ThiwankaReiss/Steering_mini_car_falcone/ADS DV.docx

Automated Driving

System (ADS)

By Thiwanka Reiss

## Summary

(100-200 words)

## Table of Contents

# 1 CAN Bus implementation (Controller Area network)

FS-AI_API (https://github.com/FS-AI/FS-AI_API) has been, as a reference for teams to start implementing their vehicle interface code.

After inspection of the API we were able to identify that this code was written on a Linux based system and socket can have been used, but we are planning to use a NUCLEO L037RZ (STM32) as the low-level micro controller which do not support Linux, it supports bare-metal C/C++.

Data frames and program structure in the code was identified and changed to work for our use case in the NUCLEO L037.

Here our focus is sending data to the VCU from API and receiving data from VCU to the API.

Some the Data frames that were identified and added to Readme file of our repository is shown below. (Note that code is fully implemented, some data frames is yet to be added to the ReadMe file)

Repository: - https://github.com/FalconE-Racing/DV_Real.git

Data frames Used to Communicate from the Api to VCU (User side - Set Method)

Frame Id | Frame Use
0x510 | VCU status
0x511 | Drive Forward
0x512 | Drive Rear
0x513 | Steering
0x514 | Brake

Note that the bits in a byte are numbered from zero to seven

VCU Status
Frame Id:- 0x510
DLC :- 8

Byte | Signal | Description
data0 | Hand shake bit | Only the 0th bit is used where, 1 = bit recived , 0 = bit not received
data1 | Dirrection , mission and stop request | 6 th bit , 1 = Forward , 0 = Neutral
| | 5th, 4th bit , 0 = Mission not selected, 1 = Mission selected, 2 = Mission Running, 3 = Mission Finished
| | 0th bit , 0 = Emenrgency Stop No , 1 = Emergency Stop Yes
data2 | Lap Counter | 0th to 3rd bit , maximum of 15 laps is expected
data3 | Cone Count | Expecting value from 0 - 255
data4 | Total Cone Count | 0th to 7th bits of Total cone count
data5 | TOtal Cone Count | 8th to 17th bit of Total cone count

Drive Forward
Frame Id:- 0x511
DLC :- 4

Byte | Signal | Description
data0 | Front Axel Torque Request | 0th to 7th bits of Torque Request
data1 | Front Axel Torque Request | 8th to 15th bits of Torque Request
data2 | Front Axel Motor Speed Request | 0th to 7th bits of Motor Speed Request
data3 | Front Axel Motor Speed Request | 8th to 15th bits of Motor Speed Request

Drive Rear
Frame Id:- 0x512
DLC :- 4

Byte | Signal | Description
data0 | Rear Axel Torque Request | 0th to 7th bits of Torque Request
data1 | Rear Axel Torque Request | 8th to 15th bits of Torque Request
data2 | Rear Axel Motor Speed Request | 0th to 7th bits of Motor Speed Request
data3 | Rear Axel Motor Speed Request | 8th to 15th bits of Motor Speed Request

Steering
Frame Id:- 0x513
DLC :- 2

Byte | Signal | Description
data0 | Steer Angle Request | 0th to 7th bits of Steer Angle Request
data1 | Steer Angle Request | 8th to 15th bits of Steer Angle Request

Brake
Frame Id:- 0x514
DLC :- 2

Byte | Signal | Description
data0 | Forward Pressure Required | Expecting value from 0 - 255
data1 | Rear Pressure Required | Expecting value from 0 - 255

Data frames Used to Communicate from the VCU to Api (User side - Get Method)

Frame Id | Frame Use
0x520 | VCU status
0x521 | Drive Forward
0x522 | Drive Rear
0x523 | Steering
0x524 | Brake
0x525 | Wheel Speed
0x526 | Wheel Count

VCU Status
Frame Id:- 0x520
DLC :- 3

Byte | Signal | Description
data0 | Hand shake bit | Only the 0th bit is used where, 1 = bit recived , 0 = bit not received
data1 | Ready to GO Signal | 3rd bit, 1 = Ready to Go, 0 = Not Ready to Go
data2 | Autonomous State (AS) | 0th to 3rd bit is used , five states are present
| | 1 - Off/ Manual
| | 2 - Ready
| | 3 - Driving
| | 4 - Emergency Brake
| | 5 - Finished
| Autonomous Mission Indicator (AMI) | 4th to 7th bit , seven states are present
| | 0 - AMI Not Selected
| | 1 - AMI Accelleration
| | 2 - AMI Skidpad
| | 3 - AMI Autocross
| | 4 - AMI Trackdrive
| | 5 - AMI Static Inspection A
| | 6 - AMI Static Inspection B
| | 7 - AMI Autonomous Demo

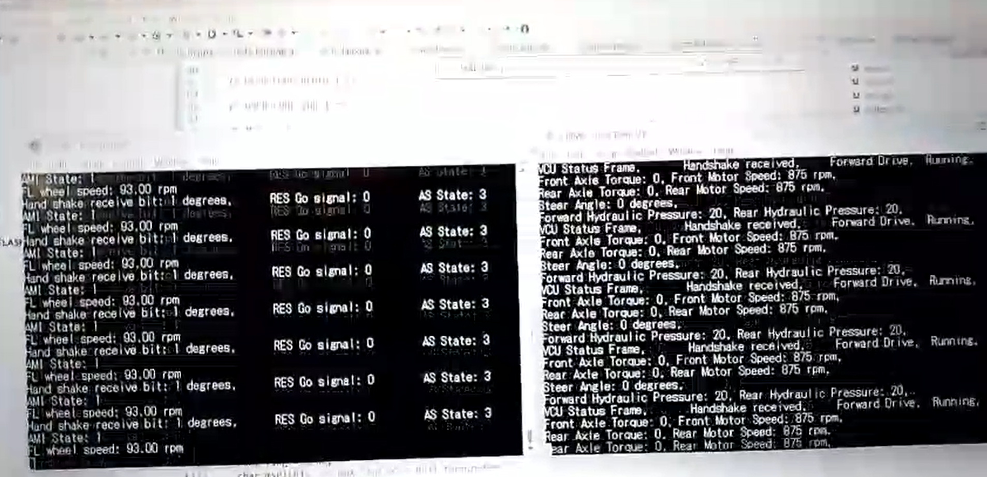
[picture p2: figure]

Designing smaller four-wheel robot for testing out the driverless stack.

To test out our code we are planning to implement a smaller four-wheel robot. A steering system was developed for the robot. Some calculations were done regarding the mechanism using python.

Wheel base = 20cm

Distance between front and rear axel = 22.22cm

Maximum steering angle = 40.1 deg

Distance from mid-point of read axel to mean of canters of rotation =30cm

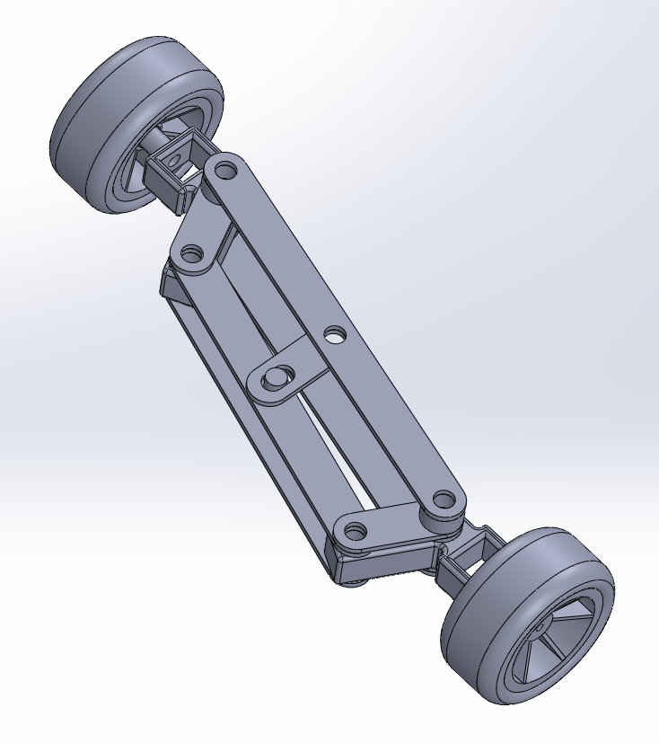
[picture p3: figure]

Calculating maximum steer angle, centre of rotation and other parameters required for the design.

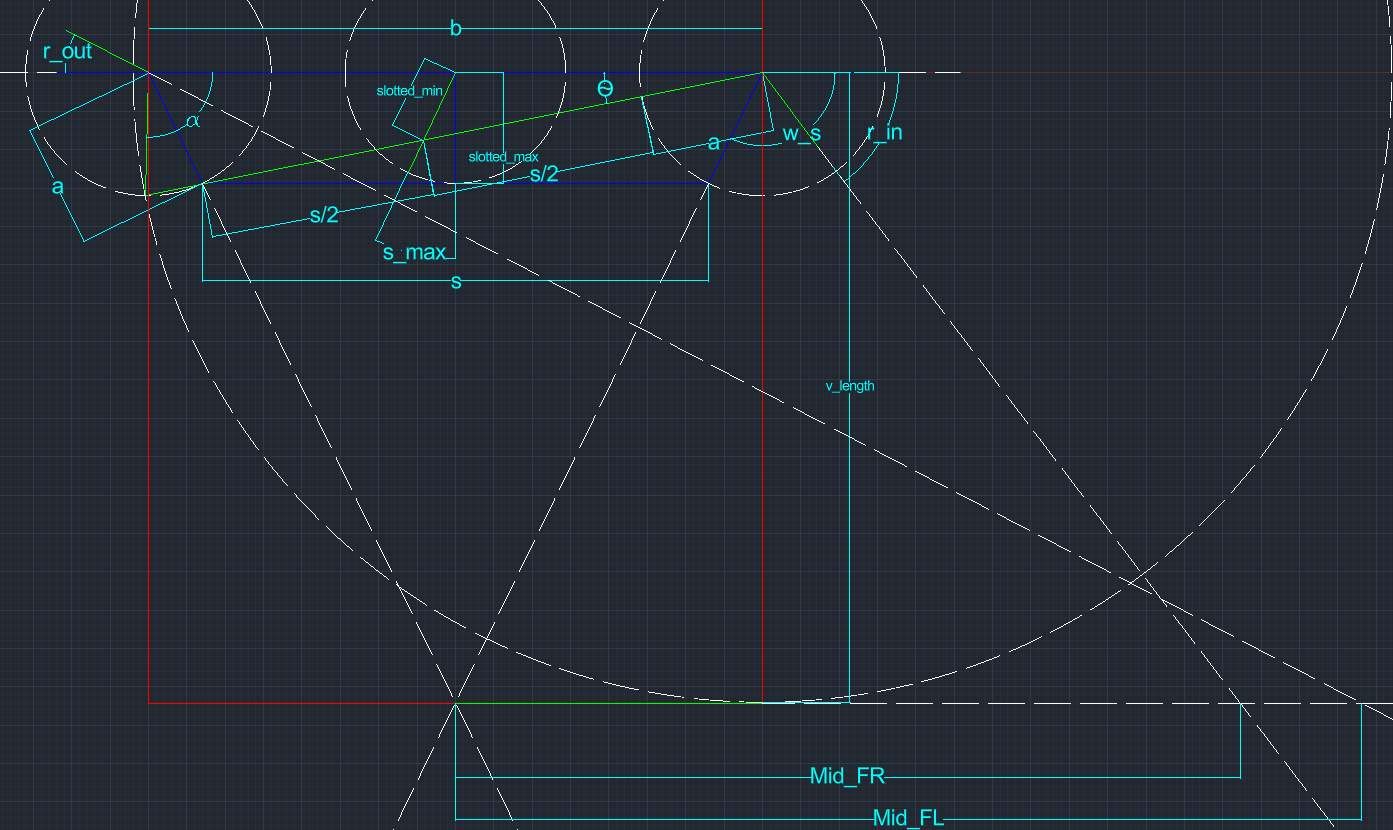
[picture p4: figure]

Slotted Level Max Length=slotted_max=√(a^2 -((b-s)/2)^2)

⁡θ=cos^(-1) (b^2 +(s+a)^2 -a^2)/(2⋅b⋅(s+a))

Slotted Level Min Length = slotted_min=√((b/2)^2 +(s/2, a)^2 -2⋅b/2⋅(s/2, a)⋅cos⁡θ)

Max Steering Angle=cos^(-1) (((b/2)^2 +(slotted_min)^2 -(s/2, a)^2)/(2⋅b/2⋅slotted_min))-90

Vehicle Length=v_length =(a⋅b)/(b-s)

180-w_s=cos^(-1) ((b-s)/(2a))⁡

w_s=180-cos^(-1) ((b-s)/(2a))

r_in=(180-w_s)-θ

α=cos^(-1) ((b^2 -(s+a)^2 +a^2)/(2⋅b⋅a))

r_out=α-(180-w_s)

Mid_FL=((v_length)/(tan(r_(out) )))-b/2

Mid_FR=((v_length)/(tan⁡(r_in)))+b/2

Average= (Mid_FL+ Mid_FR)/2

SolidWorks Simulation

Steering angle vs Iner front wheel.

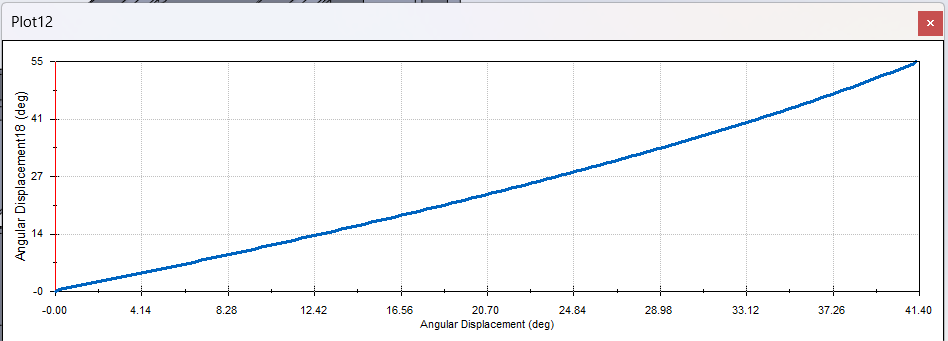
[picture p5: figure]

Steering angle vs Outer front wheel.

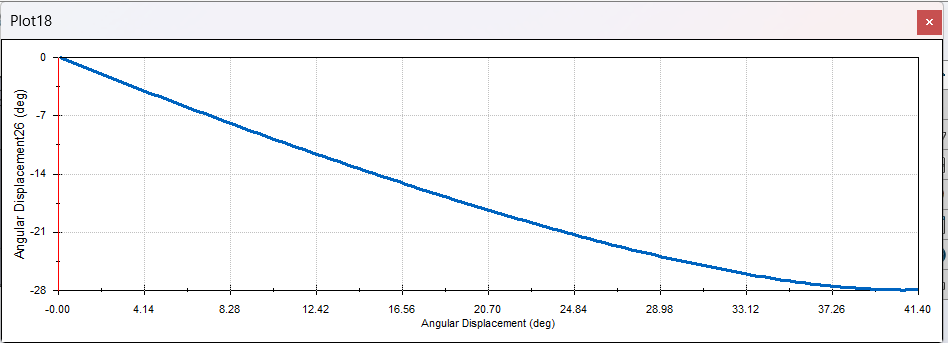
[picture p6: figure]
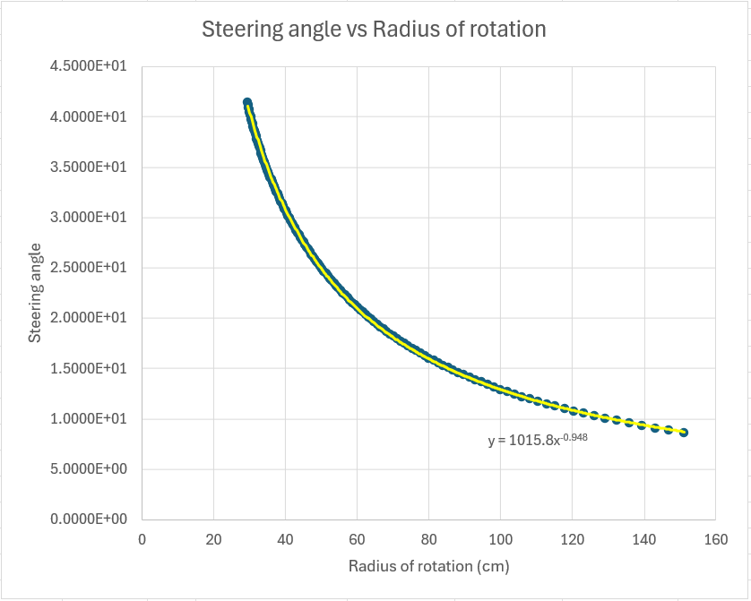
[picture p7: figure]

Solid works data

Steering Angle (deg) | Outer wheel angle (deg) | Inner Wheel Angle (deg)
Ref. Coordinate System: | Ref. Coordinate System: | Ref. Coordinate System:
-1.2762E-14 | 5.1659E-11 | -2.8010E-11
2.3931E-01 | -2.4055E-01 | 2.3806E-01
4.7861E-01 | -4.8051E-01 | 4.7671E-01
7.1792E-01 | -7.1988E-01 | 7.1595E-01
9.5723E-01 | -9.5867E-01 | 9.5578E-01
1.1965E+00 | -1.1969E+00 | 1.1962E+00
1.4358E+00 | -1.4345E+00 | 1.4372E+00
1.6751E+00 | -1.6715E+00 | 1.6788E+00
1.9145E+00 | -1.9079E+00 | 1.9210E+00
2.1538E+00 | -2.1437E+00 | 2.1638E+00
2.3931E+00 | -2.3790E+00 | 2.4072E+00
2.6324E+00 | -2.6136E+00 | 2.6511E+00
2.8717E+00 | -2.8477E+00 | 2.8957E+00
3.1110E+00 | -3.0811E+00 | 3.1408E+00
3.3503E+00 | -3.3140E+00 | 3.3866E+00
3.5896E+00 | -3.5463E+00 | 3.6329E+00
3.8289E+00 | -3.7780E+00 | 3.8798E+00
4.0682E+00 | -4.0091E+00 | 4.1274E+00
4.3075E+00 | -4.2395E+00 | 4.3755E+00
4.5468E+00 | -4.4694E+00 | 4.6242E+00
4.7861E+00 | -4.6987E+00 | 4.8736E+00
5.0254E+00 | -4.9274E+00 | 5.1235E+00
5.2647E+00 | -5.1555E+00 | 5.3740E+00
5.5040E+00 | -5.3829E+00 | 5.6252E+00
5.7434E+00 | -5.6098E+00 | 5.8769E+00
5.9827E+00 | -5.8361E+00 | 6.1293E+00
6.2220E+00 | -6.0617E+00 | 6.3822E+00
6.4613E+00 | -6.2868E+00 | 6.6358E+00
6.7006E+00 | -6.5112E+00 | 6.8900E+00
6.9399E+00 | -6.7350E+00 | 7.1448E+00
7.1792E+00 | -6.9582E+00 | 7.4002E+00
7.4185E+00 | -7.1808E+00 | 7.6563E+00
7.6578E+00 | -7.4027E+00 | 7.9129E+00
7.8971E+00 | -7.6240E+00 | 8.1702E+00
8.1364E+00 | -7.8447E+00 | 8.4282E+00
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
3.4699E+01 | -2.6809E+01 | 4.2591E+01
3.4939E+01 | -2.6898E+01 | 4.2980E+01
3.5178E+01 | -2.6985E+01 | 4.3372E+01
3.5417E+01 | -2.7070E+01 | 4.3766E+01
3.5657E+01 | -2.7151E+01 | 4.4163E+01
3.5896E+01 | -2.7230E+01 | 4.4563E+01
3.6135E+01 | -2.7306E+01 | 4.4965E+01
3.6375E+01 | -2.7379E+01 | 4.5371E+01
3.6614E+01 | -2.7449E+01 | 4.5779E+01
3.6853E+01 | -2.7516E+01 | 4.6191E+01
3.7092E+01 | -2.7580E+01 | 4.6606E+01
3.7332E+01 | -2.7641E+01 | 4.7024E+01
3.7571E+01 | -2.7698E+01 | 4.7445E+01
3.7810E+01 | -2.7752E+01 | 4.7870E+01
3.8050E+01 | -2.7802E+01 | 4.8298E+01
3.8289E+01 | -2.7849E+01 | 4.8730E+01
3.8528E+01 | -2.7892E+01 | 4.9165E+01
3.8768E+01 | -2.7931E+01 | 4.9605E+01
3.9007E+01 | -2.7967E+01 | 5.0048E+01
3.9246E+01 | -2.7998E+01 | 5.0496E+01
3.9486E+01 | -2.8025E+01 | 5.0947E+01
3.9725E+01 | -2.8048E+01 | 5.1403E+01
3.9964E+01 | -2.8066E+01 | 5.1863E+01
4.0203E+01 | -2.8080E+01 | 5.2328E+01
4.0443E+01 | -2.8089E+01 | 5.2798E+01
4.0682E+01 | -2.8093E+01 | 5.3272E+01
4.0921E+01 | -2.8092E+01 | 5.3752E+01
4.1161E+01 | -2.8086E+01 | 5.4236E+01
4.1400E+01 | -2.8075E+01 | 5.4726E+01
