ThiwankaReiss/Steering_mini_car_falcone/Backup Assembly/Assem1.SLDASM

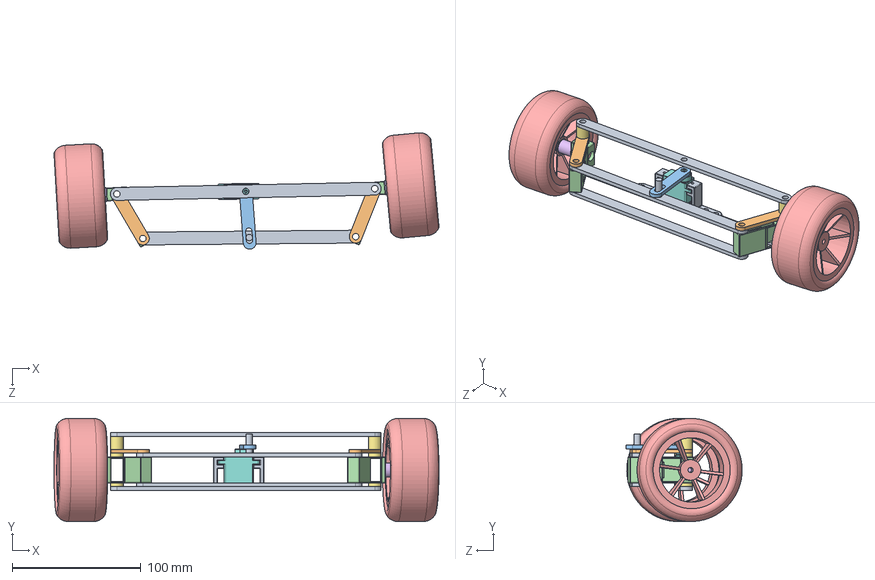
[picture p8: CAD file, 2026-07-10]
Backup Assembly/Assem1.SLDASM
298.6 x 80.0 x 90.3 mm
wheel x 2
wheel_insert x 2
collition_avoider x 6
Motor
motorSupport x 2
