ThiwankaReiss/Steering_mini_car_falcone/Assem1.SLDASM

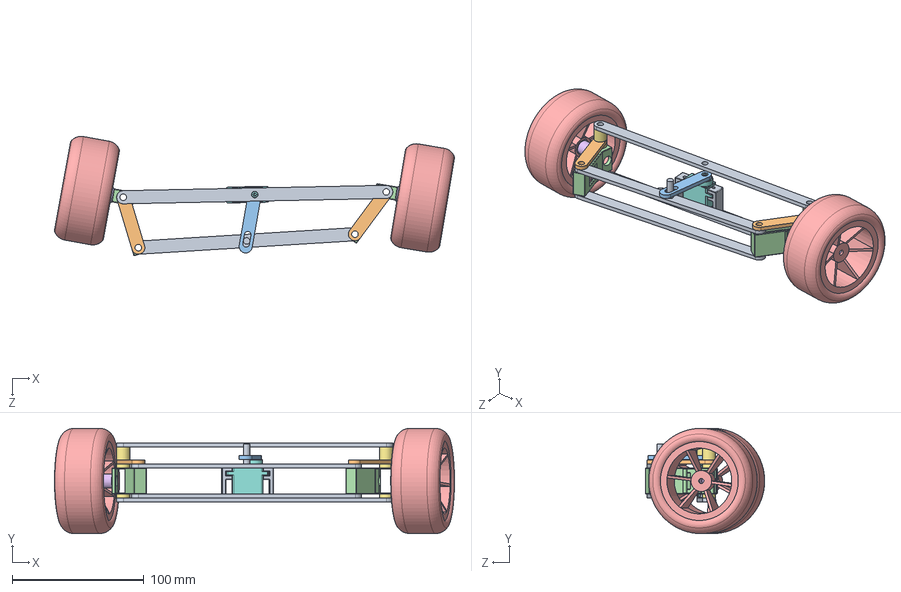
[picture p9: CAD file, 2026-07-10]
Assem1.SLDASM
304.0 x 80.0 x 90.7 mm
wheel x 2
wheel_insert x 2
collition_avoider x 6
Motor
motorSupport x 2
