ThiwankaReiss/Steering_mini_car_falcone/Assem2.SLDASM

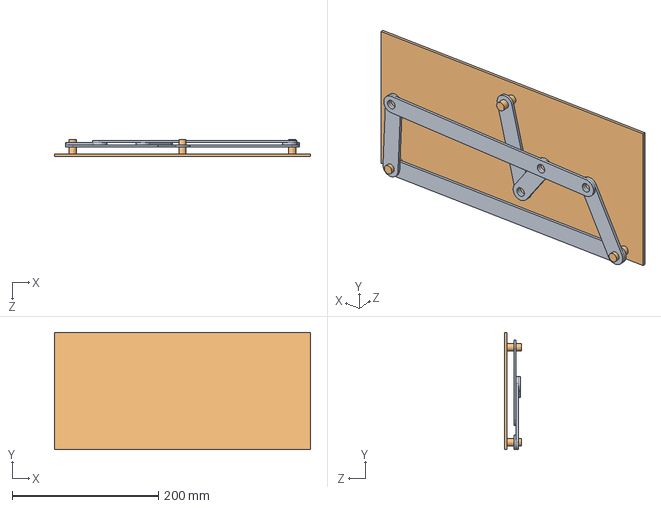
[picture p10: CAD file, 2026-07-10]
Assem2.SLDASM
350.0 x 160.0 x 23.0 mm
