ThiwankaReiss/Steering_mini_car_falcone/Motor.SLDPRT

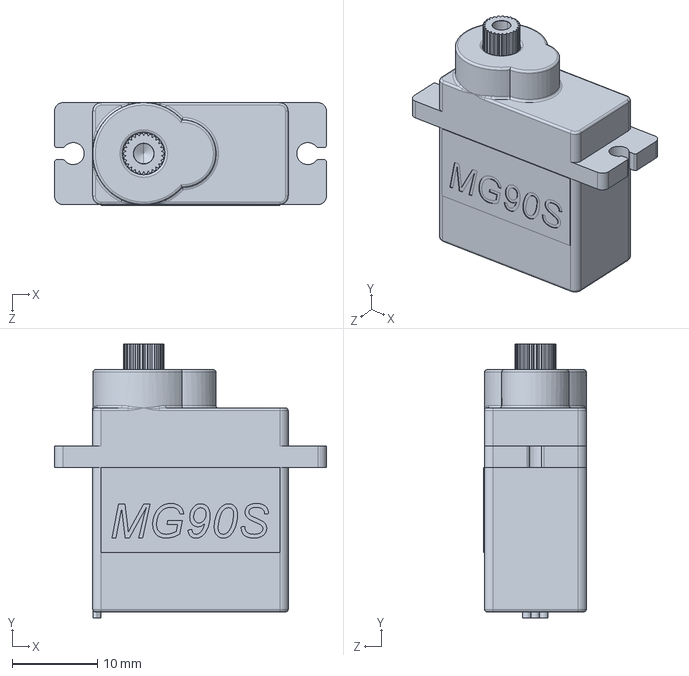
[picture p11: CAD file, 2026-07-10]
Motor.SLDPRT
32.0 x 32.2 x 12.1 mm
