ThiwankaReiss/Steering_mini_car_falcone/motorSupport.SLDPRT

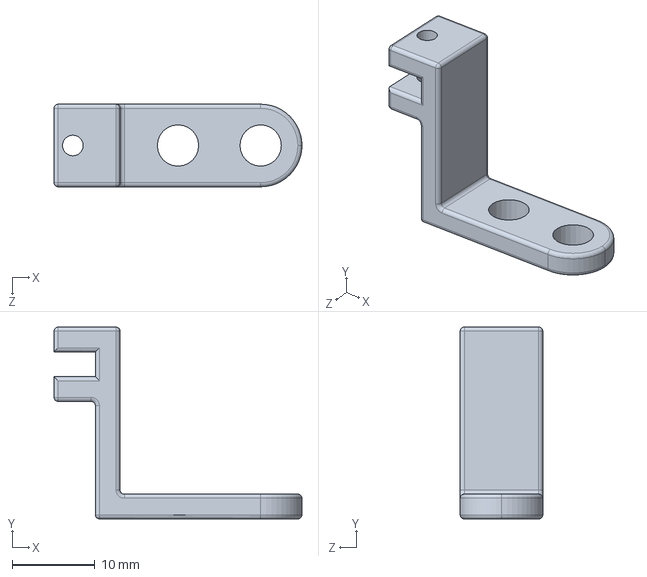
[picture p12: CAD file, 2026-07-10]
motorSupport.SLDPRT
30.0 x 23.2 x 10.0 mm
