ThiwankaReiss/Steering_mini_car_falcone/Part5.SLDPRT

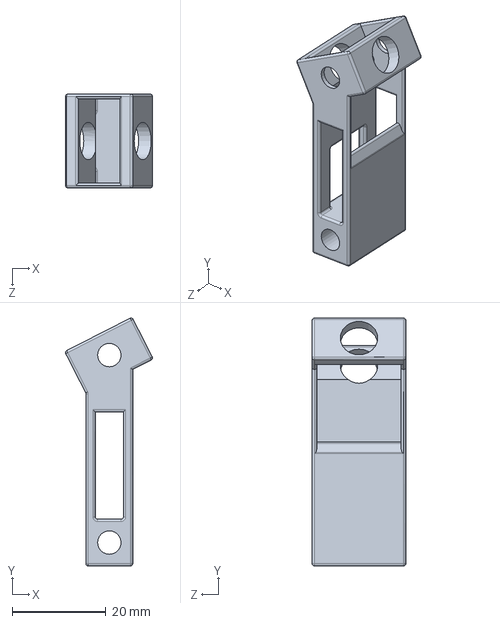
[picture p13: CAD file, 2026-07-10]
Part5.SLDPRT
18.6 x 52.9 x 20.0 mm
