ThiwankaReiss/Steering_mini_car_falcone/Part4.SLDPRT

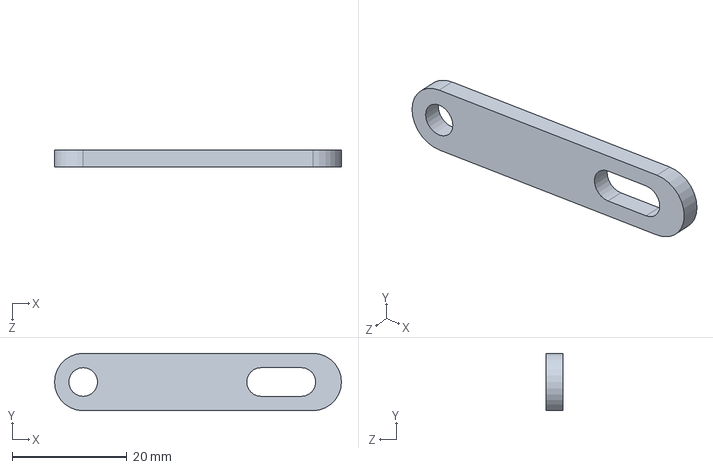
[picture p14: CAD file, 2026-07-10]
Part4.SLDPRT
50.0 x 10.0 x 3.00 mm
