ThiwankaReiss/Steering_mini_car_falcone/Part3.SLDPRT

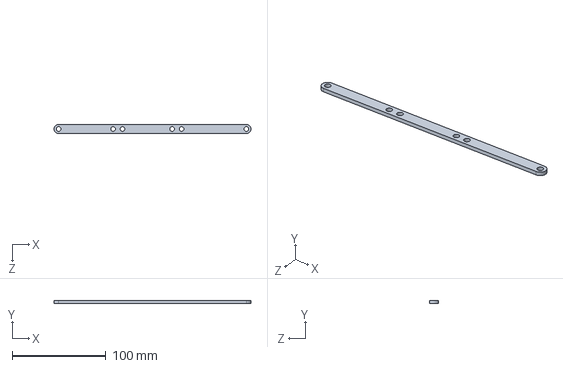
[picture p15: CAD file, 2026-07-10]
Part3.SLDPRT
210.0 x 3.00 x 10.0 mm
