ThiwankaReiss/Steering_mini_car_falcone/collition_avoider.SLDPRT

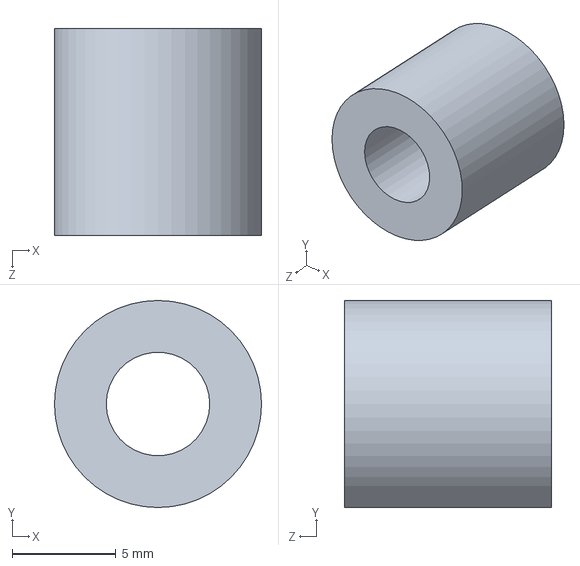
[picture p16: CAD file, 2026-07-10]
collition_avoider.SLDPRT
10.0 x 10.0 x 10.0 mm
