ThiwankaReiss/Steering_mini_car_falcone/Part2.SLDPRT

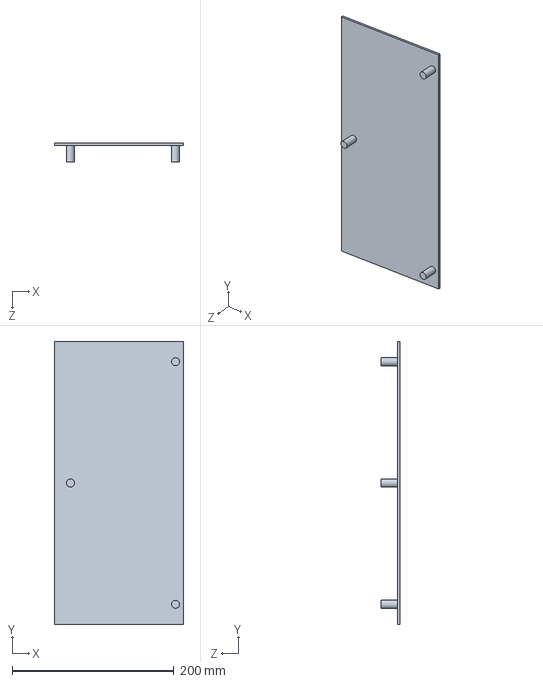
[picture p17: CAD file, 2026-07-10]
Part2.SLDPRT
160.0 x 350.0 x 23.0 mm
