ThiwankaReiss/Steering_mini_car_falcone/Part1.SLDPRT

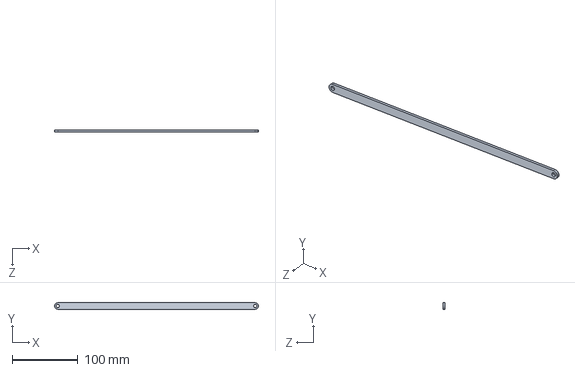
[picture p18: CAD file, 2026-07-10]
Part1.SLDPRT
310.0 x 10.0 x 3.00 mm
