ThiwankaReiss/Steering_mini_car_falcone/(list of files, cad)

Other CAD files:
Drawing2.dwg
Drawing1.dwg
